IFAKA/utter/hardware/out/fab/render-top.png

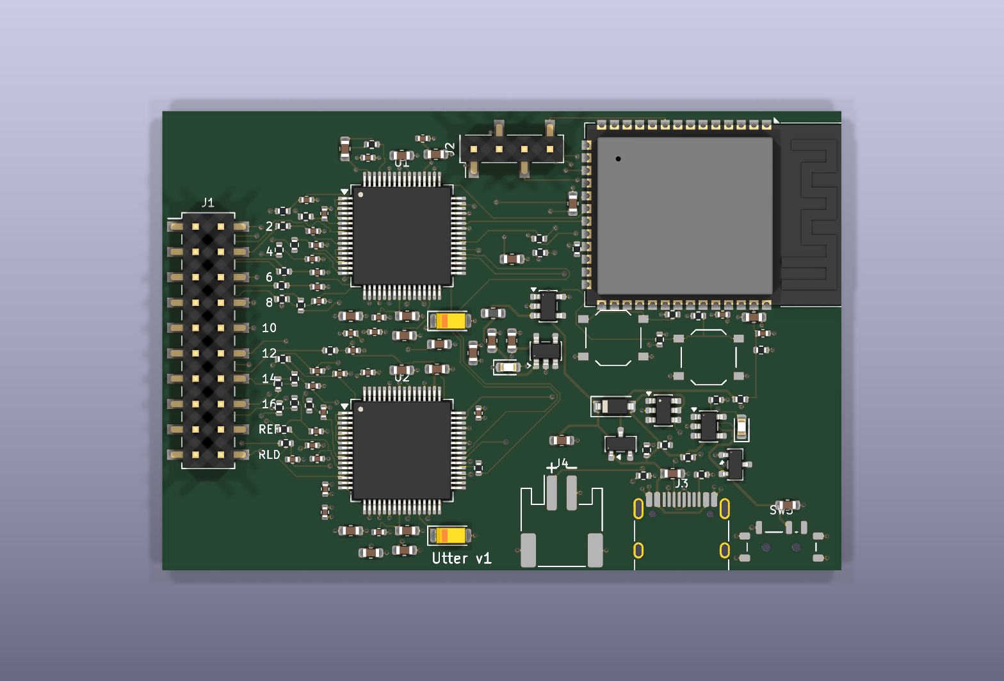
hardware/out/fab/render-top.png
