IFAKA/utter/hardware/out/fab/render-bottom.png

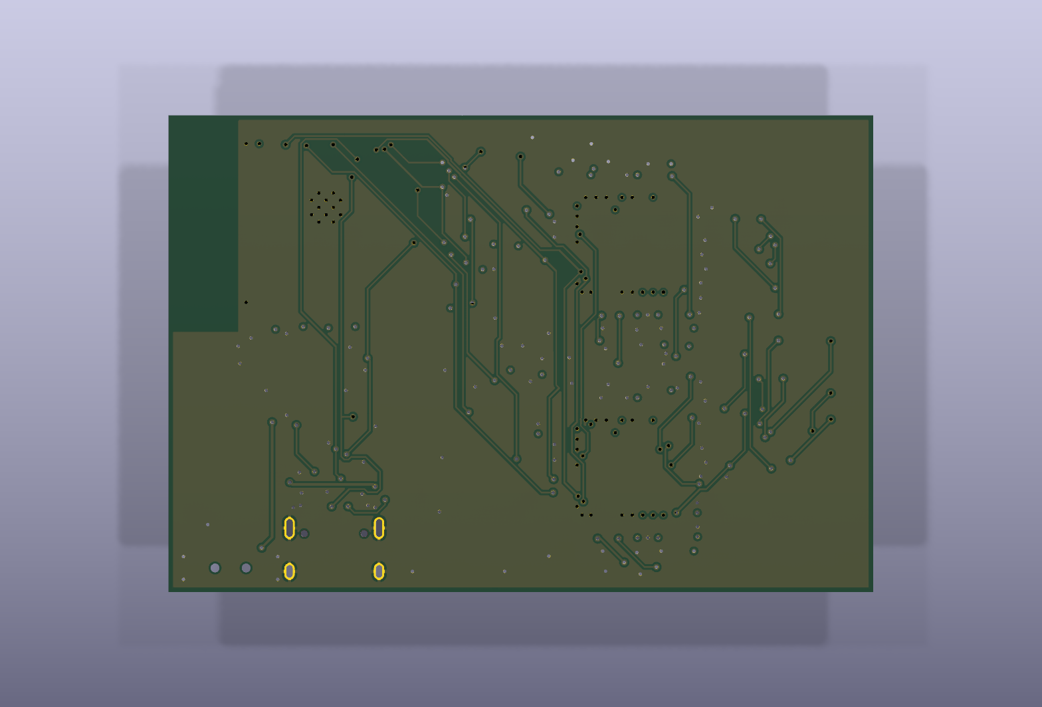
hardware/out/fab/render-bottom.png
