IFAKA/utter/docs/assets/board.png

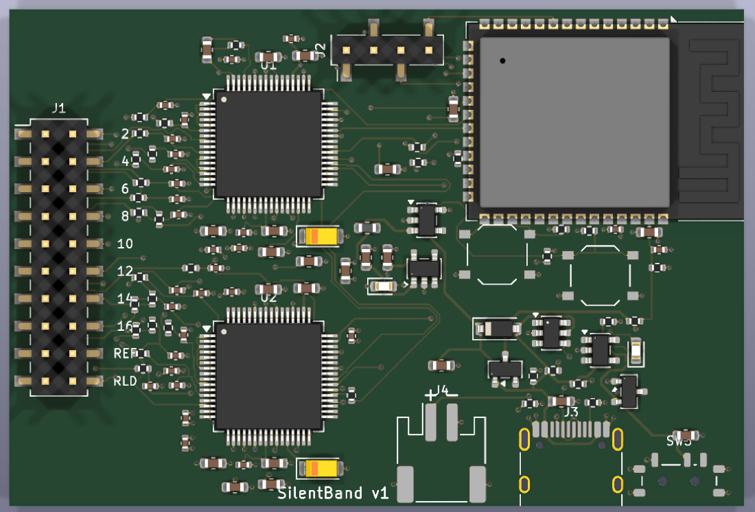
docs/assets/board.png
