IFAKA/utter/hardware/out/fab/utter-bom.csv

Comment | Designator | Footprint | LCSC Part # | Quantity
470p C0G | C1,C2,C3,C4,C5,C6,C7,C8,C9,C10,C11,C12,C13,C14,C15,C16,C17 | C_0402_1005Metric | C75274 | 17
10u | C18,C30,C43,C46,C47,C48,C50,C53 | C_0603_1608Metric | C19702 | 8
100n | C19,C25,C26,C27,C29,C31,C37,C38,C39,C41,C44,C49 | C_0402_1005Metric | C1525 | 12
22u | C20,C32 | CP_EIA-3216-18_Kemet-A | C7183 | 2
1u | C21,C22,C23,C24,C28,C33,C34,C35,C36,C40,C45,C51,C52 | C_0603_1608Metric | C15849 | 13
2.2n | C42 | C_0603_1608Metric | C1604 | 1
red | D1,D2 | LED_0603_1608Metric | C2286 | 2
B5819W | D3 | D_SOD-123 | C8598 | 1
600R@100MHz | FB1 | L_0603_1608Metric | C1002 | 1
Electrodes | J1 | PinHeader_2x10_P2.54mm_Vertical_SMD | C42372532 | 1
IMU | J2 | PinHeader_1x04_P2.54mm_Vertical_SMD_Pin1Left | C46061677 | 1
USB-C | J3 | USB_C_Receptacle_HRO_TYPE-C-31-M-12 | C165948 | 1
LiPo 1S | J4 | JST_PH_S2B-PH-SM4-TB_1x02-1MP_P2.00mm_Horizontal | C295747 | 1
AO3401A | Q1,Q2 | SOT-23 | C15127 | 2
10k | R1,R2,R3,R4,R5,R6,R7,R8,R9,R10,R11,R12,R13,R14,R15,R16,R17,R20,R21,R22 | R_0402_1005Metric | C25744 | 20
33 | R18 | R_0402_1005Metric | C25105 | 1
1M | R19 | R_0402_1005Metric | C26083 | 1
1k | R23,R31 | R_0402_1005Metric | C11702 | 2
4.7k | R24,R25,R30 | R_0402_1005Metric | C25900 | 3
5.1k | R26,R27 | R_0402_1005Metric | C25905 | 2
100k | R28,R29,R32,R33,R34 | R_0402_1005Metric | C25741 | 5
RESET | SW1 | SW_Push_1P1T_XKB_TS-1187A | C318884 | 1
BOOT | SW2 | SW_Push_1P1T_XKB_TS-1187A | C318884 | 1
POWER | SW3 | SW_SPDT_Shouhan_MSK12C02 | C431540 | 1
ADS1298IPAGR | U1,U2 | TQFP-64_10x10mm_P0.5mm | C527440 | 2
ESP32-S3-WROOM-1-N8 | U3 | ESP32-S3-WROOM-1 | C2913198 | 1
USBLC6-2SC6 | U4 | SOT-23-6 | C7519 | 1
MCP73831T-2ACI/OT | U5 | SOT-23-5 | C424093 | 1
AP2112K-3.3TRG1 | U6 | SOT-23-5 | C51118 | 1
LP5907MFX-3.0/NOPB | U7 | SOT-23-5 | C475492 | 1
