IFAKA/utter/hardware/enclosure/out/pod_base.stl

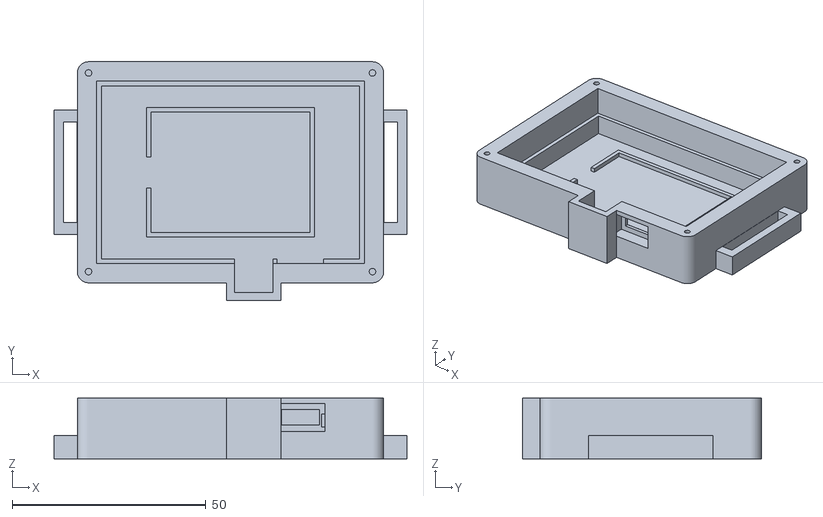
[picture p4: CAD file, 2026-10-19]
hardware/enclosure/out/pod_base.stl
91.0 x 61.5 x 15.6
