IFAKA/utter/hardware/enclosure/out/pod_lid.stl

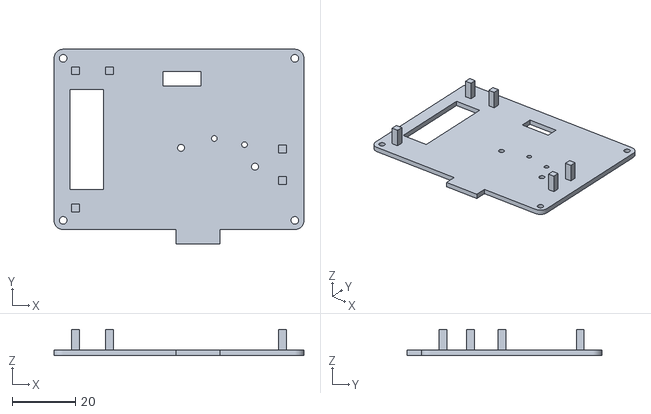
[picture p5: CAD file, 2026-10-19]
hardware/enclosure/out/pod_lid.stl
79.0 x 61.5 x 8.30
