IFAKA/utter/hardware/out/fab/utter-schematic.pdf

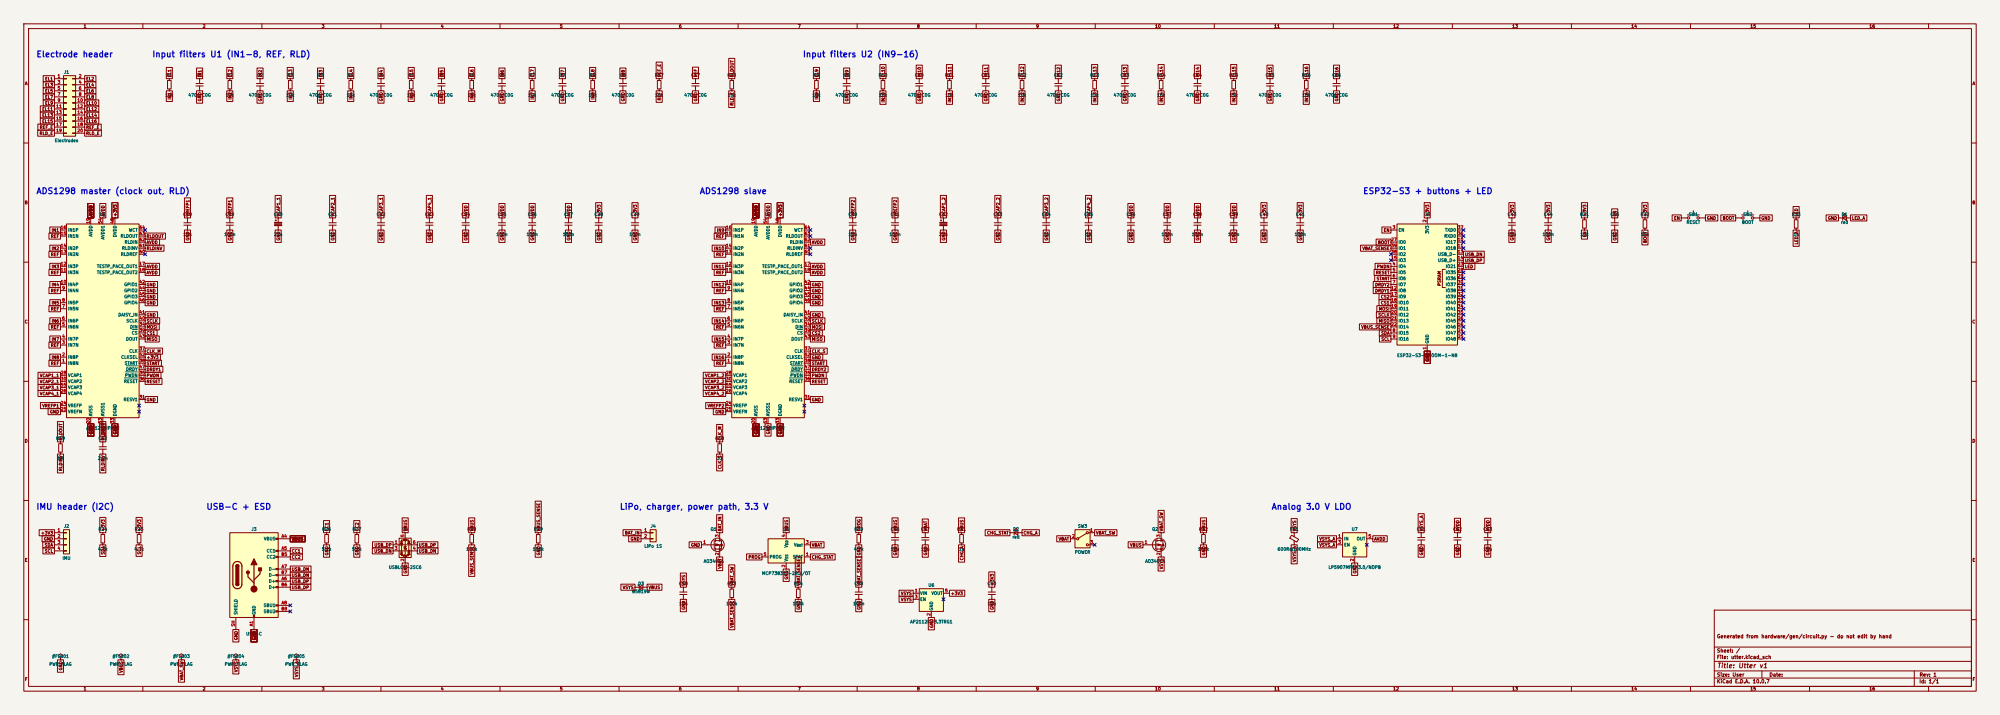
[picture p6: page 1]

ADS1298 master (clock out, RLD)

LiPo, charger, power path, 3.3 V

Generated from hardware/gen/circuit.py - do not edit by hand

Size: User | Rev: 1 | F Date:
KiCad E.D.A. 10.0.7 | Id: 1/1
