IFAKA/utter/hardware/out/fab/utter-top-assembly.pdf

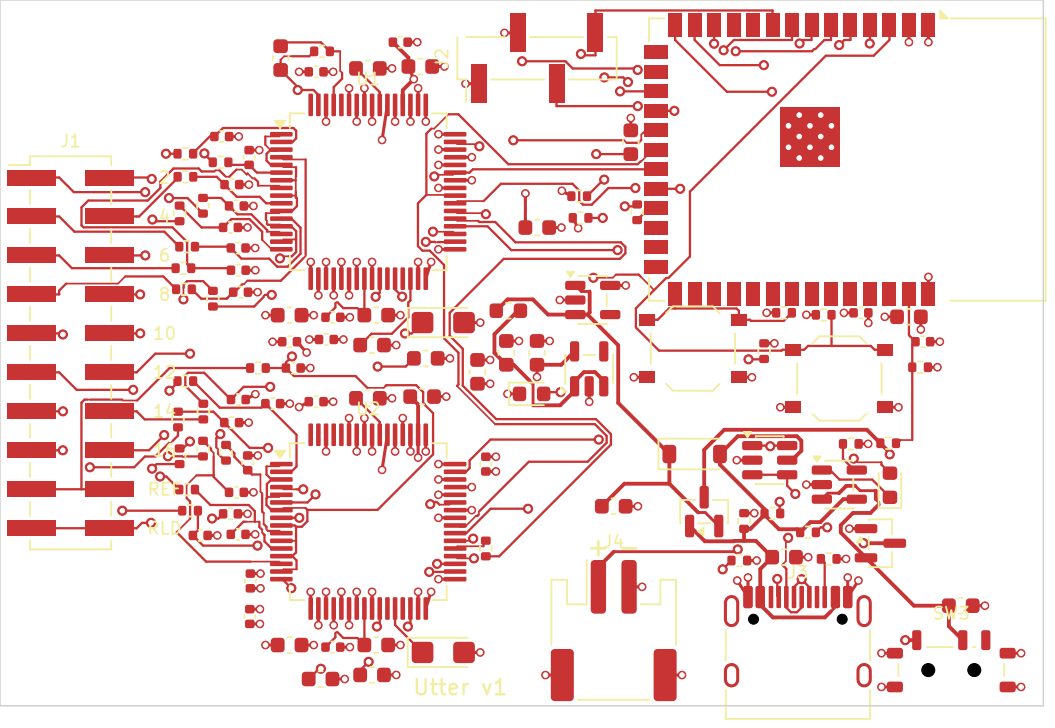
[picture p7: page 1]
