IFAKA/utter/hardware/out/utter.kicad_pcb

## KiCad design hardware/out/utter.kicad_pcb (2026-10-19)

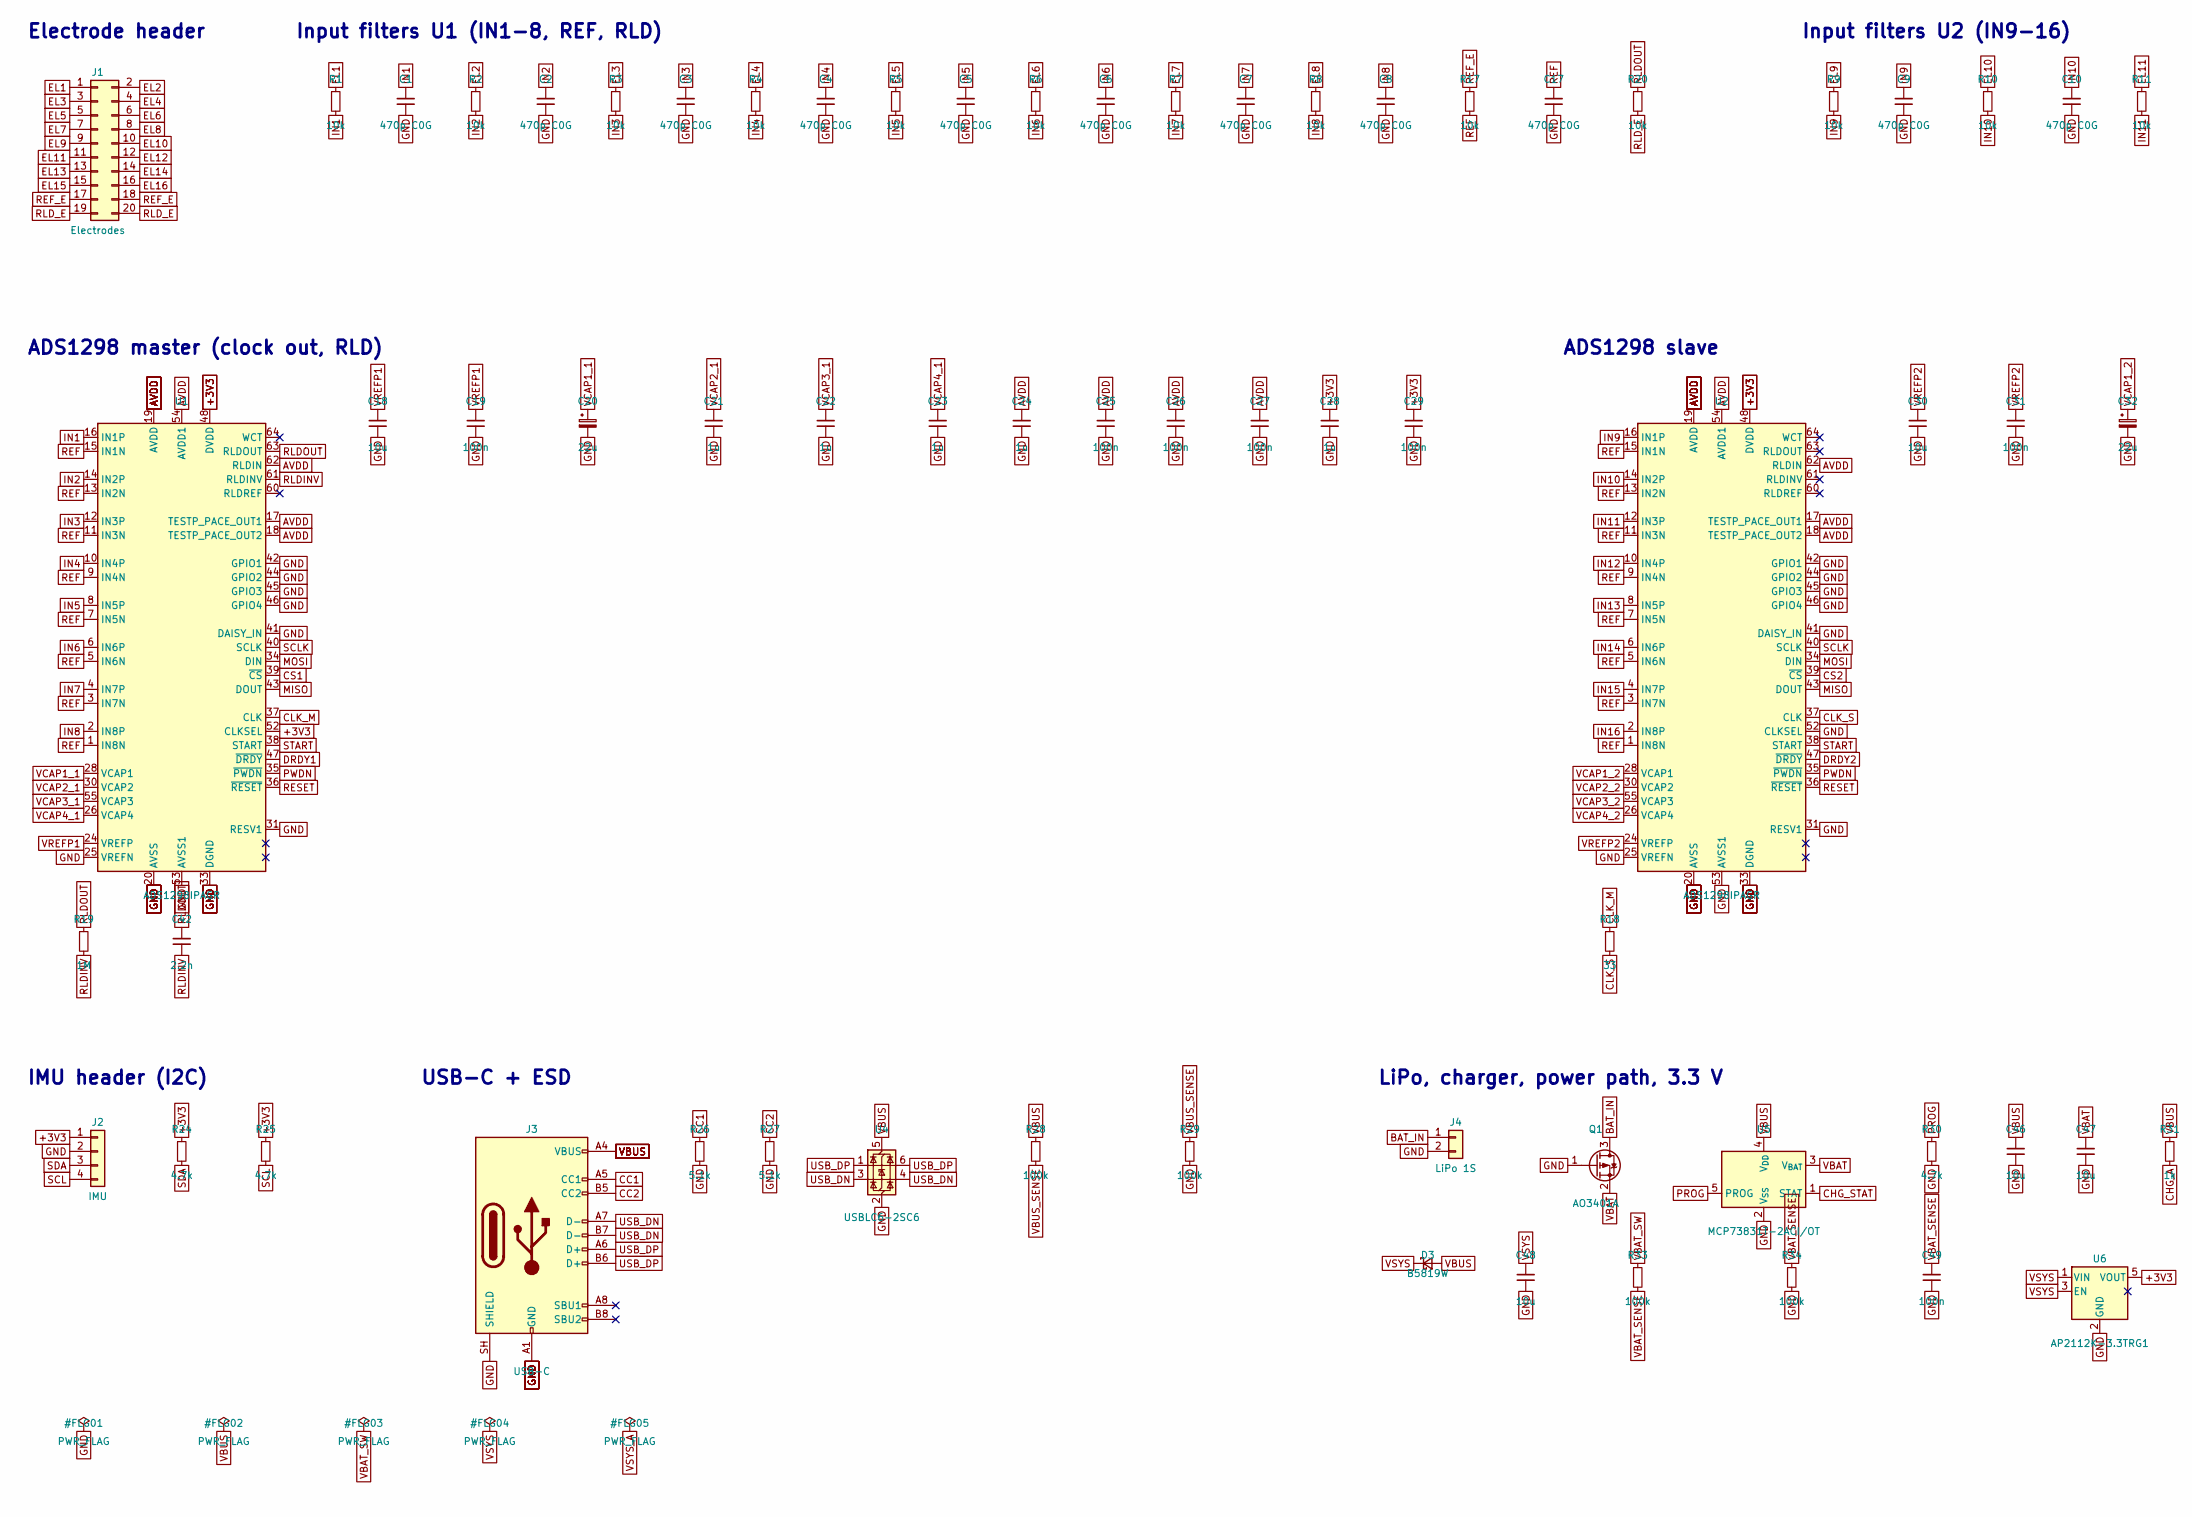
[picture p8: schematic utter.kicad_sch, Utter v1, part in row 1, column 1]

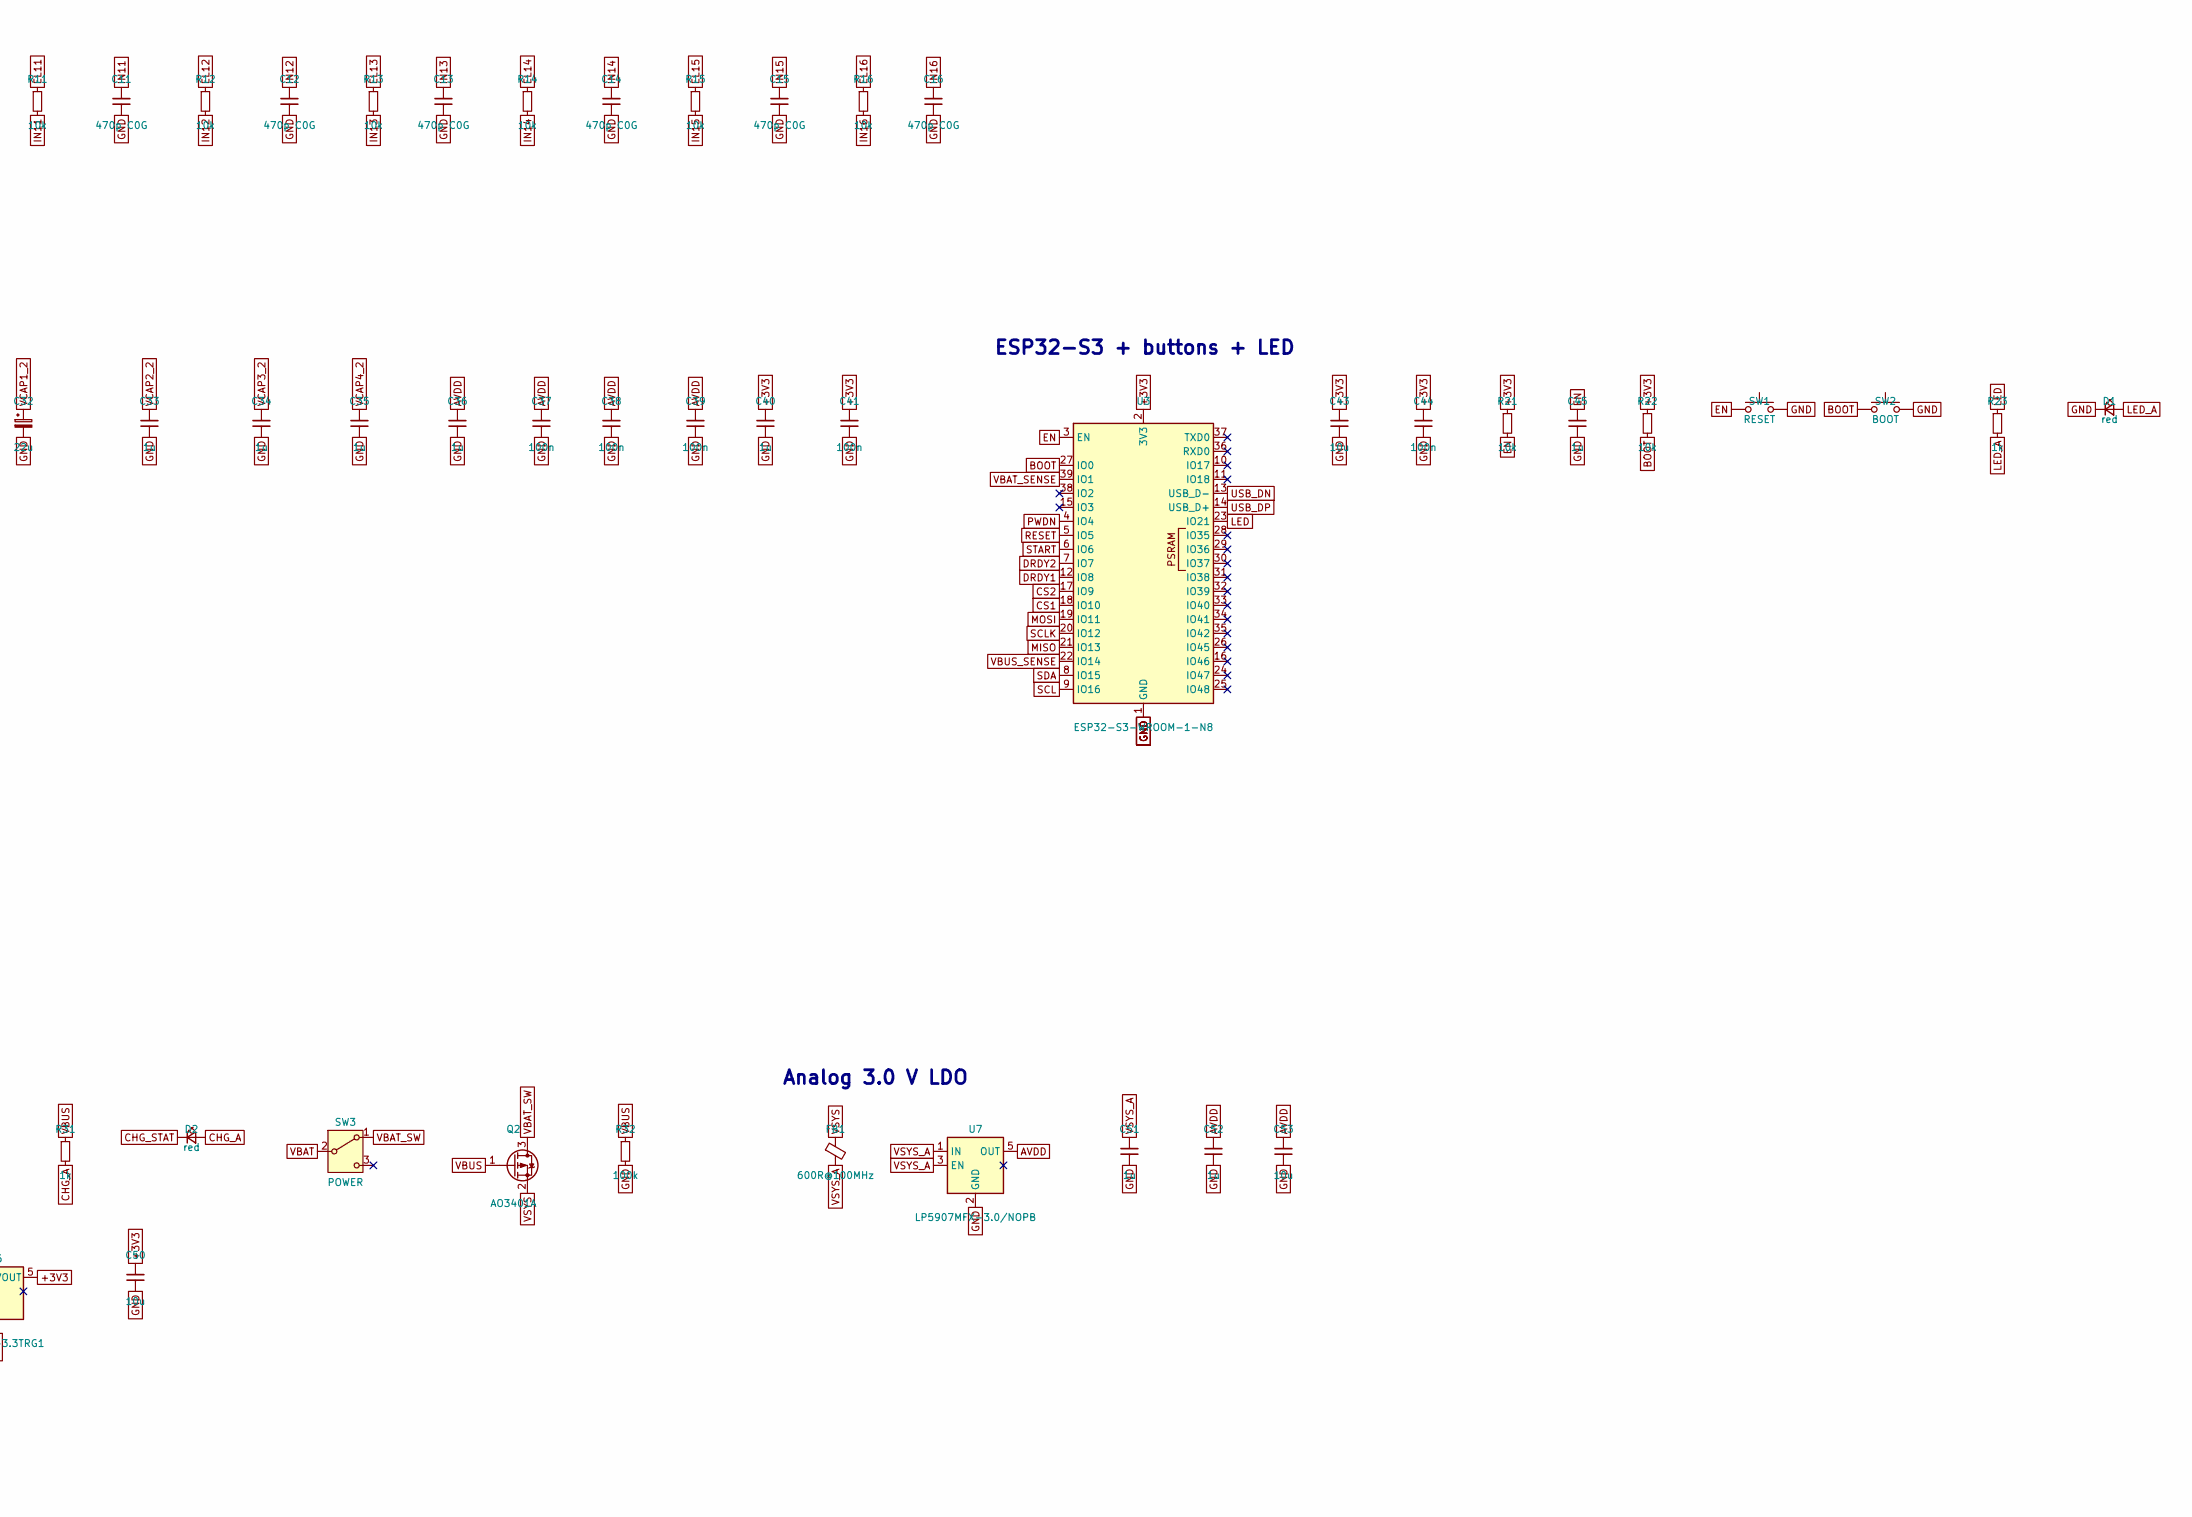
[picture p9: schematic utter.kicad_sch, Utter v1, part in row 1, column 2]

Parts:
C1, C2, C3, C4, C5, C6, C7, C8, C9, C10, C11, C12, C13, C14, C15, C16, C17: 470p C0G; C_0402_1005Metric; LCSC C75274
C18, C30, C43, C46, C47, C48, C50, C53: 10u; C_0603_1608Metric; LCSC C19702
C19, C25, C26, C27, C29, C31, C37, C38, C39, C41, C44, C49: 100n; C_0402_1005Metric; LCSC C1525
C20, C32: 22u; CP_EIA-3216-18_Kemet-A; LCSC C7183
C21, C22, C23, C24, C28, C33, C34, C35, C36, C40, C45, C51, C52: 1u; C_0603_1608Metric; LCSC C15849
C42: 2.2n; C_0603_1608Metric; LCSC C1604
D1, D2: red; LED_0603_1608Metric; LCSC C2286
D3: B5819W; D_SOD-123; LCSC C8598
FB1: 600R@100MHz; L_0603_1608Metric; LCSC C1002
J1: Electrodes; PinHeader_2x10_P2.54mm_Vertical_SMD; LCSC C42372532
J2: IMU; PinHeader_1x04_P2.54mm_Vertical_SMD_Pin1Left; LCSC C46061677
J3: USB-C; USB_C_Receptacle_HRO_TYPE-C-31-M-12; LCSC C165948
J4: LiPo 1S; JST_PH_S2B-PH-SM4-TB_1x02-1MP_P2.00mm_Horizontal; LCSC C295747
Q1, Q2: AO3401A; SOT-23; LCSC C15127
R1, R2, R3, R4, R5, R6, R7, R8, R9, R10, R11, R12, R13, R14, R15, R16, R17, R20, R21, R22: 10k; R_0402_1005Metric; LCSC C25744
R18: 33; R_0402_1005Metric; LCSC C25105
R19: 1M; R_0402_1005Metric; LCSC C26083
R23, R31: 1k; R_0402_1005Metric; LCSC C11702
R24, R25, R30: 4.7k; R_0402_1005Metric; LCSC C25900
R26, R27: 5.1k; R_0402_1005Metric; LCSC C25905
R28, R29, R32, R33, R34: 100k; R_0402_1005Metric; LCSC C25741
SW1: RESET; SW_Push_1P1T_XKB_TS-1187A; LCSC C318884
SW2: BOOT; SW_Push_1P1T_XKB_TS-1187A; LCSC C318884
SW3: POWER; SW_SPDT_Shouhan_MSK12C02; LCSC C431540
U1, U2: ADS1298IPAGR; TQFP-64_10x10mm_P0.5mm; LCSC C527440
U3: ESP32-S3-WROOM-1-N8; ESP32-S3-WROOM-1; LCSC C2913198
U4: USBLC6-2SC6; SOT-23-6; LCSC C7519
U5: MCP73831T-2ACI/OT; SOT-23-5; LCSC C424093
U6: AP2112K-3.3TRG1; SOT-23-5; LCSC C51118
U7: LP5907MFX-3.0/NOPB; SOT-23-5; LCSC C475492

Connections:
+3V3: C28.1, C29.1, C40.1, C41.1, C43.1, C44.1, C50.1, J2.1, R21.1, R22.1, R24.1, R25.1, U1.48 (DVDD), U1.50 (DVDD), U1.52 (CLKSEL), U2.48 (DVDD), U2.50 (DVDD), U3.2 (3V3), U6.5 (VOUT)
AVDD: C24.1, C25.1, C26.1, C27.1, C36.1, C37.1, C38.1, C39.1, C52.1, C53.1, U1.17 (TESTP_PACE_OUT1), U1.18 (TESTP_PACE_OUT2), U1.19 (AVDD), U1.21 (AVDD), U1.22 (AVDD), U1.54 (AVDD1), U1.56 (AVDD), U1.59 (AVDD), U1.62 (RLDIN), U2.17 (TESTP_PACE_OUT1), U2.18 (TESTP_PACE_OUT2), U2.19 (AVDD), U2.21 (AVDD), U2.22 (AVDD), U2.54 (AVDD1), U2.56 (AVDD), U2.59 (AVDD), U2.62 (RLDIN), U7.5 (OUT)
BAT_IN: J4.1, Q1.3 (D)
BOOT: R22.2, SW2.1, U3.27 (IO0)
CC1: J3.A5 (CC1), R26.1
CC2: J3.B5 (CC2), R27.1
CHG_A: D2.2 (A), R31.2
CHG_STAT: D2.1 (K), U5.1 (STAT)
CLK_M: R18.1, U1.37 (CLK)
CLK_S: R18.2, U2.37 (CLK)
CS1: U1.39 (~CS), U3.18 (IO10)
CS2: U2.39 (~CS), U3.17 (IO9)
DRDY1: U1.47 (~DRDY), U3.12 (IO8)
DRDY2: U2.47 (~DRDY), U3.7 (IO7)
EL1: J1.1, R1.1
EL2: J1.2, R2.1
EL3: J1.3, R3.1
EL4: J1.4, R4.1
EL5: J1.5, R5.1
EL6: J1.6, R6.1
EL7: J1.7, R7.1
EL8: J1.8, R8.1
EL9: J1.9, R9.1
EL10: J1.10, R10.1
EL11: J1.11, R11.1
EL12: J1.12, R12.1
EL13: J1.13, R13.1
EL14: J1.14, R14.1
EL15: J1.15, R15.1
EL16: J1.16, R16.1
EN: C45.1, R21.2, SW1.1, U3.3 (EN)
GND: C1.2, C2.2, C3.2, C4.2, C5.2, C6.2, C7.2, C8.2, C9.2, C10.2, C11.2, C12.2, C13.2, C14.2, C15.2, C16.2, C17.2, C18.2, C19.2, C20.2, C21.2, C22.2, C23.2, C24.2, C25.2, C26.2, C27.2, C28.2, C29.2, C30.2, C31.2, C32.2, C33.2, C34.2, C35.2, C36.2, C37.2, C38.2, C39.2, C40.2, C41.2, C43.2, C44.2, C45.2, C46.2, C47.2, C48.2, C49.2, C50.2, C51.2, C52.2, C53.2, D1.1 (K), J2.2, J3.A1 (GND), J3.A12 (GND), J3.B1 (GND), J3.B12 (GND), J3.SH (SHIELD), J4.2, J4.MP, Q1.1 (G), R26.2, R27.2, R29.2, R30.2, R32.2, R34.2, SW1.2, SW2.2, SW3.SH, U1.20 (AVSS), U1.23 (AVSS), U1.25 (VREFN), U1.31 (RESV1), U1.32 (AVSS), U1.33 (DGND), U1.41 (DAISY_IN), U1.42 (GPIO1), U1.44 (GPIO2), U1.45 (GPIO3), U1.46 (GPIO4), U1.49 (DGND), U1.51 (DGND), U1.53 (AVSS1), U1.57 (AVSS), U1.58 (AVSS), U2.20 (AVSS), U2.23 (AVSS), U2.25 (VREFN), U2.31 (RESV1), U2.32 (AVSS), U2.33 (DGND), U2.41 (DAISY_IN), U2.42 (GPIO1), U2.44 (GPIO2), U2.45 (GPIO3), U2.46 (GPIO4), U2.49 (DGND), U2.51 (DGND), U2.52 (CLKSEL), U2.53 (AVSS1), U2.57 (AVSS), U2.58 (AVSS), U3.1 (GND), U3.40 (GND), U3.41 (GND), U4.2 (GND), U5.2 (V_{SS}), U6.2 (GND), U7.2 (GND)
IN1: C1.1, R1.2, U1.16 (IN1P)
IN2: C2.1, R2.2, U1.14 (IN2P)
IN3: C3.1, R3.2, U1.12 (IN3P)
IN4: C4.1, R4.2, U1.10 (IN4P)
IN5: C5.1, R5.2, U1.8 (IN5P)
IN6: C6.1, R6.2, U1.6 (IN6P)
IN7: C7.1, R7.2, U1.4 (IN7P)
IN8: C8.1, R8.2, U1.2 (IN8P)
IN9: C9.1, R9.2, U2.16 (IN1P)
IN10: C10.1, R10.2, U2.14 (IN2P)
IN11: C11.1, R11.2, U2.12 (IN3P)
IN12: C12.1, R12.2, U2.10 (IN4P)
IN13: C13.1, R13.2, U2.8 (IN5P)
IN14: C14.1, R14.2, U2.6 (IN6P)
IN15: C15.1, R15.2, U2.4 (IN7P)
IN16: C16.1, R16.2, U2.2 (IN8P)
LED: R23.1, U3.23 (IO21)
LED_A: D1.2 (A), R23.2
MISO: U1.43 (DOUT), U2.43 (DOUT), U3.21 (IO13)
MOSI: U1.34 (DIN), U2.34 (DIN), U3.19 (IO11)
NC_LDO1: U6.4 (NC)
NC_LDO2: U7.4 (NC)
NC_SW: SW3.3 (C)
PROG: R30.1, U5.5 (PROG)
PWDN: U1.35 (~PWDN), U2.35 (~PWDN), U3.4 (IO4)
REF: C17.1, R17.2, U1.1 (IN8N), U1.3 (IN7N), U1.5 (IN6N), U1.7 (IN5N), U1.9 (IN4N), U1.11 (IN3N), U1.13 (IN2N), U1.15 (IN1N), U2.1 (IN8N), U2.3 (IN7N), U2.5 (IN6N), U2.7 (IN5N), U2.9 (IN4N), U2.11 (IN3N), U2.13 (IN2N), U2.15 (IN1N)
REF_E: J1.17, J1.18, R17.1
RESET: U1.36 (~RESET), U2.36 (~RESET), U3.5 (IO5)
RLDINV: C42.2, R19.2, U1.61 (RLDINV)
RLDOUT: C42.1, R19.1, R20.1, U1.63 (RLDOUT)
RLD_E: J1.19, J1.20, R20.2
SCL: J2.4, R25.2, U3.9 (IO16)
SCLK: U1.40 (SCLK), U2.40 (SCLK), U3.20 (IO12)
SDA: J2.3, R24.2, U3.8 (IO15)
START: U1.38 (START), U2.38 (START), U3.6 (IO6)
USB_DN: J3.A7 (D-), J3.B7 (D-), U3.13 (USB_D-), U4.3 (I/O2), U4.4 (I/O2)
USB_DP: J3.A6 (D+), J3.B6 (D+), U3.14 (USB_D+), U4.1 (I/O1), U4.6 (I/O1)
VBAT: C47.1, Q1.2 (S), SW3.2 (B), U5.3 (V_{BAT})
VBAT_SENSE: C49.1, R33.2, R34.1, U3.39 (IO1)
VBAT_SW: Q2.3 (D), R33.1, SW3.1 (A)
VBUS: C46.1, D3.2 (A), J3.A4 (VBUS), J3.A9 (VBUS), J3.B4 (VBUS), J3.B9 (VBUS), Q2.1 (G), R28.1, R31.1, R32.1, U4.5 (VBUS), U5.4 (V_{DD})
VBUS_SENSE: R28.2, R29.1, U3.22 (IO14)
VCAP1_1: C20.1, U1.28 (VCAP1)
VCAP1_2: C32.1, U2.28 (VCAP1)
VCAP2_1: C21.1, U1.30 (VCAP2)
VCAP2_2: C33.1, U2.30 (VCAP2)
VCAP3_1: C22.1, U1.55 (VCAP3)
VCAP3_2: C34.1, U2.55 (VCAP3)
VCAP4_1: C23.1, U1.26 (VCAP4)
VCAP4_2: C35.1, U2.26 (VCAP4)
VREFP1: C18.1, C19.1, U1.24 (VREFP)
VREFP2: C30.1, C31.1, U2.24 (VREFP)
VSYS: C48.1, D3.1 (K), FB1.1, Q2.2 (S), U6.1 (VIN), U6.3 (EN)
VSYS_A: C51.1, FB1.2, U7.1 (IN), U7.3 (EN)

Notes on the sheet:
Electrode header
Input filters U1 (IN1-8, REF, RLD)
Input filters U2 (IN9-16)
ADS1298 master (clock out, RLD)
ADS1298 slave
ESP32-S3 + buttons + LED
IMU header (I2C)
USB-C + ESD
LiPo, charger, power path, 3.3 V
Analog 3.0 V LDO

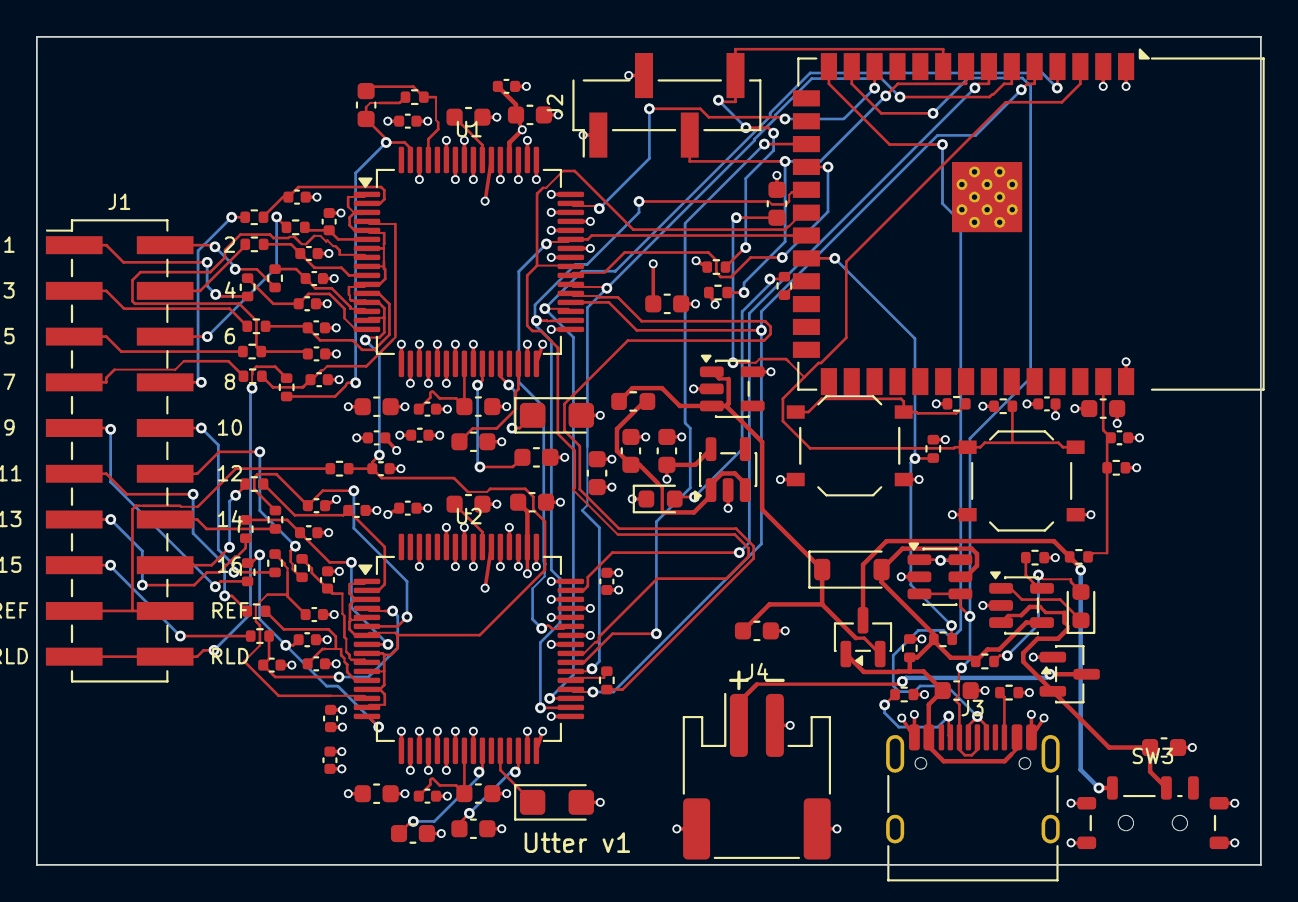
[picture p10: board utter.kicad_pcb from above]

Board: 4 copper layers, 68.0 x 46.0 mm, 107 parts (0 on the bottom side), 83 nets.
