IFAKA/utter/(commit log)

2026-10-19 Add SilentBand v1 board, firmware, host tools, Mac app, docs
    [silentband-B_Cu.gbl, silentband-B_Mask.gbs, silentband-B_Silkscreen.gbo, silentband-Edge_Cuts.gm1, silentband-F_Cu.gtl, silentband-F_Mask.gts, silentband-F_Paste.gtp, silentband-F_Silkscreen.gto]
2026-10-19 Apply Fable review: slave reset timing, tantalum VCAP1, clocks on F.Cu, low-battery stop
    [silentband-B_Cu.gbl, silentband-B_Mask.gbs, silentband-B_Silkscreen.gbo, silentband-Edge_Cuts.gm1, silentband-F_Cu.gtl, silentband-F_Mask.gts, silentband-F_Paste.gtp, silentband-F_Silkscreen.gto]
2026-10-19 Add live scope and interactive fake-board engine demo
2026-10-19 Landing page: user-POV single-product page (hero, a day with SilentBand, how it works, agents, hardware, status, FAQ)
2026-10-19 Printable enclosure, 3D kit viewer, and the v1 prototype worn on the hero head
    - hardware/enclosure/pod.py: PETG case for the board + 503040 cell, with fit check against every footprint; web.py exports docs/assets/kit.js
    - ORDER.md: housing print/assembly, screws and strap, battery size limit
    - demo.html: 'In the box' exploded kit viewer; hero shows the real kit (case on strap, 16 electrodes + REF/RLD, leads into J1) with a Prototype v1 / Concept toggle
    [pod_base.stl, pod_lid.stl]
2026-10-19 Rename the product to Utter (formerly SilentBand / SilentTyping)
    The board, Mac app, utter CLI and Python package, firmware, mDNS (utter.local), docs and landing page all use the new name.
    The board was regenerated with build.sh --reuse-route (new flag). The copper is identical to the reviewed layout, DRC/ERC are clean, and the BOM and CPL are unchanged.
    USAGE paths point to the renamed repo folder (utter/).
    [silentband.kicad_pcb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]
2026-10-20 Demo: mobile layout, full-screen Try it with one-way scroll detent
    - Phones get a link row under the top bar instead of hiding the menu
    - Try it becomes a full-screen phone screen with finger-sized keys
    - Scrolling down stops on it sticky-style; pushing past it unplugs with a rubber-band spring
    - Touch: hover-only hints swapped for tap wording; WebGL pixel ratio capped on touch devices
    - Layout tightened below 600px
2026-10-20 SpeechNet + cross-day recovery, neckband layout, spell mode, real-error typing gate
    - ml: SilentWear loader and SpeechNet port (paper config); crossday.py tests per-day
    normalization, augmentation, AdaBN, online learning and cross-subject pre-training
    (next day 62% -> 70.5% zero-shot, ~83% after online learning)
    - st-gate replays real recognizer outputs (--confusions/--map/--p-min); passes 48/48 x4
    seeds on next-day errors with confidence rejection at 0.7 (engine p_min default)
    - train.assign_actions maps tokens to actions by expected confusion cost
    - neckband.py: SilentWear-style 16-electrode layout, 13 software bipolar pairs, wired
    into train, channel ranking and the electrode chec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
    [cli.py, crossday.py, engine.py, lm.py, neckband.py, silentwear.py, speechnet.py]
2026-10-20 Demo and context: neckband with dry electrodes, offline word model only, dark-mode phone fix
    - 3D hero, kit viewer and SVG fallback show the fabric neckband and the neckband.py electrode layout
    - Drop the 137 MB SmolLM2 button; Try it uses the bundled 1.4 MB LSTM
    - Text reflects SpeechNet cross-day results, adaptive window, reply memory
    - CONTEXT.md updated to 2026-10-20
2026-10-20 Paced UX: again?/too fast notices, queued commands, confirm unsure sends; demo follows the band's pace
    [appbus.py, dsp.py, engine.py]
2026-10-20 Silent syllable candidates: vary the vowel, not only the tongue spot (neck sensors confuse ada/aga/aka); hook comment names moves
